AK-Homberger/NMEA2000-Data-Sender/(threads)

Thread 2 (2023-07-01):

Zwei mal G23 im Bild des ESP32

Martin-Stein, 2023-07-01:
Hallo,
In der Zeichnung gibt es auf dem Bild des ESP-32 zwei mal den Port G23! Einmal ist er mit den beiden Widerstanänden der 12V Spannung verbunden, einmal ist er frei. (rechts oben).Auf meinem realen ESP ist an Stelle des linken G23, der Port G33.
Welches ist der richtige?

Danke & Gruß,

Martin Stein

Martin-Stein, 2023-07-01:
muss mich korrigieren , geht nicht zur Spannungsmessung, sondern zur Drehzahl.

Thread 3 (2024-01-21):

NMEA2000-Data-Sender

greenhouse69, 2024-01-21:
Hallo, ich fange gerade mit diesem Thema an und teste deinen NMEA2000-Data-Sender-Code. Es gibt eine Zeile, die ich nicht verstehe: unsigned int size; in void loop() {. Warum wird diese Variable deklariert? Welchen Wert hat sie? Was ist ihr Zweck? Ich habe keine Referenz zu dieser Variable in deinem Code gefunden. Danke.

AK-Homberger, 2024-01-21:
Hallo,

die Variable "size" wird in dieser Version des Programms nicht benötigt. Die Zeile kann gelöscht werden.

Weitere, und besser beschriebene Programmteile, gibt es im NMEA2000-Workshop.

Viele Grüße
Andreas

greenhouse69, 2024-01-21:
Vielen Dank für Ihre Antwort. Jetzt bin ich sicherer in meinen Überlegungen.

Thread 4 (2024-03-24):

Spannungsteiler Widerstandsmessung

jojoa, 2024-03-24:
Ich kann die Berechnung der Widerstandsmessung nicht nachvollziehen. Wenn ich den Teiler wie aufgebaut nachrechne komme ich auf maximal 763mV am Ausgang. Was aber nicht mit dem Faktor von 250 im Code zusammenpasst, was bei meiner Berechnung nur ca 47% Füllstand ergibt. Wie kann das sein, ist hier ein Fehler im Code/Aufbau oder habe ich einen Denkfehler. Ich würde doch einen kleineren Wiederstand als 1k nehmen um den Bereich bis 3,3V auszunutzen.

AK-Homberger, 2024-03-25:
Die 250 im Code sind nur ein Beispiel. Deswegen steht in der Anleitung auch: "The ADC value has to be calibrated in the code.". Ein kleinerer Widerstand geht, solange die 3,3 V nicht überschritten werden.

Thread 5 (2024-10-21):

Timer API is rewritten

gunderv, 2024-10-21:
The Espressif ESP32 board library has been revised to v3.x.x since last update of the sketch. The timer() function used on line 113 has been rewritten to only allow one argument, while the sketch, based on esp32 2.0.x has three arguments.

To not having to modify the sketch, rolling back to esp32 2.0.x in the Arduino board manager will solve the issue and give no compile error.

Thread 6 (2024-11-01):

xSemaphoreGiveFromISR should be used in interrupt handler. Debouncing code is missing too

mgrouch, 2024-11-01:
xSemaphoreGiveFromISR should be used in interrupt handler.

Debouncing code is missing too. Without debouncing in interrupt handler the counts might be wrong.

Here is an article with examples on how to debounce and synchronize interrupt handler with another task

https://circuitdigest.com/microcontroller-projects/arduino-freertos-tutorial-using-semaphore-and-mutex-in-freertos-with-arduino

Thanks

Thread 7 (2025-03-11):

Wiring to nmea2k bus

theboss0539, 2025-03-11:
just want to confirm the wiring in to nmea2k system

nmea2k connector has 5 pins should i wire them

pin 4 - can h
pin 5  - can l

or

Pin 1 - ?
pin 2 - 12v
pin 3 - ground
pin 4 - can H
pin 5 - can L

gerryvel, 2025-04-06:
Pin 1 - Shield
pin 2 - 12v
pin 3 - ground
pin 4 - can H
pin 5 - can L

this is the pin-confuration for M12 Connector.
