AK-Homberger/NMEA2000-Data-Sender/(commit log)

2019-10-07 Added Zener Diode to protect GPIO if TGT200 is not connected
2020-02-15 Added Battery Voltage
2020-02-16 Added different Temperature PGNs
2020-03-03 Corrected GND connection.
2020-08-04 Changed CAN TX pin from 2 to 5.
2020-08-04 Changed TX pin from 2 to 5. Store/restore NodeAddress. Lower task priority (GetTemp.)
2021-04-21 Korrected GPIO pin from 23 to 33.
2021-04-21 Corrected GPIO pin from 23 to 33.
2022-02-05 Use new ESP32-API function name "esp_efuse_mac_get_default(chipid);"
